SJLee-83/rccar_ota_project/README.md

# SDV 시대의 RC카 - 무선 OTA 업데이트와 AI 음성 제어

SSAFY 임베디드 트랙 15기 1학기 관통 PJT. 차량이 출고 후에도 소프트웨어 업데이트로 기능이 확장되는 **SDV(Software Defined Vehicle)** 개념을 RC카 규모로 구현.

- **무선 OTA 업데이트**: 제어 MCU 에 무선 모듈이 없어도 게이트웨이(ESP32)를 거쳐 펌웨어를 무선 배포하고, 바뀐 펌웨어가 주행 동작 변화로 이어지는 것까지 시연
- **AI 음성 제어**: 사용자 음성을 차량 명령으로 변환하는 인포테인먼트 기능

---

## 개발 계보

구동·제어 베이스를 먼저 구축하고, 그 위에서 OTA 구현이 두 갈래로 분기.

```mermaid
flowchart LR
    BASE["구동·제어 베이스 (이승재)<br/>RA6E1 주행 펌웨어<br/>관제 GUI · MQTT · ESP32 · SPI 명령 체인"]
    A["Dual-Bank OTA · AI 음성 제어 (팀원)<br/>이 저장소 rccar_pjt/ · 최종 시연 채택"]
    B["MCUboot 부트로더 기반 OTA (이승재)<br/>별도 저장소 · 슬롯 교체 검증까지"]

    BASE --> A
    BASE --> B
```

베이스 무선 제어 체인의 원형은 [rccar-mcuboot-ota](https://github.com/SJLee-83/rccar-mcuboot-ota) 의 `gateway/` 이고, 이 저장소 `rccar_pjt/OTA/` 의 `esp32.ino` · `mainwindow.py` 는 원형에 OTA 전송 기능이 얹힌 확장본.

---

## 시스템 아키텍처

```mermaid
flowchart TB
    GUI["PC 관제 GUI<br/>PySide6"]
    PI["Raspberry Pi 5<br/>SPH0645 I2S 마이크<br/>STT · LLM · TTS"]
    BROKER["MQTT Broker<br/>Mosquitto 1883"]
    ESP["ESP32 게이트웨이"]
    RA["Renesas RA6E1 · SPI Slave<br/>Dual-Bank Code Flash 제어<br/>CRC32 검증 · BankSwap · Reset"]
    MOTOR["PCA9685 Motor HAT<br/>서보 조향 + DC 모터 구동"]
    SONIC["HC-SR04 초음파 센서<br/>전방 충돌 감지"]

    GUI -->|MQTT| BROKER
    PI -->|MQTT| BROKER
    BROKER -->|MQTT| ESP
    ESP -->|"SPI Master + BUSY GPIO"| RA
    RA -->|I2C| MOTOR
    SONIC -->|GPIO| RA
```

| 구간 | 프로토콜 | 용도 |
|---|---|---|
| GUI ↔ Broker ↔ ESP32 | MQTT | OTA 데이터, RC 조종 명령, 상태 피드백 |
| ESP32 ↔ RA6E1 | SPI + BUSY GPIO | 펌웨어 청크 전달, 명령, 핸드셰이크 |
| RA6E1 ↔ Motor HAT | I2C | 서보·DC 모터 제어 |
| RA6E1 ↔ HC-SR04 | GPIO | 전방 거리 측정 |
| Pi5 ↔ GMS | HTTPS | STT / LLM / TTS |

---

## 주요 기능

### 1. 무선 OTA (Dual-Bank 방식, 최종 채택)

부트로더 없이 RA6E1 하드웨어의 Dual-Bank + BankSwap 기능으로 구현. 실행 중인 Active Bank 가 새 펌웨어를 받아 반대쪽 Inactive Bank(alias `0x00200000`)에 기록하고, 검증 성공 시 `R_FLASH_HP_BankSwap()` + Reset 으로 교체.

- 256바이트 청크 전송, RA6E1 에서 메타데이터·청크 CRC32 검증 (불일치 시 거부). 전체 이미지 CRC32 는 ESP32 가 전송 완료 시 대조하되 경고만 기록, RA6E1 은 수신만 하고 미대조
- ARQ 재전송 (NACK `0x1F`, 청크당 최대 20회), Session ID, 바이너리 프로토콜
- 다운로드·검증 실패 시 BankSwap 미수행으로 기존 펌웨어 유지

### 2. HC-SR04 충돌 회피 (OTA 가치 시연용)

OTA 로 펌웨어를 바꾸면 기능이 생기는 것을 보이는 시연 구성.

- **V1.0.0 (업데이트 전)**: 장애물 감지 없이 계속 주행
- **V2.0.0 (업데이트 후)**: 전방 20cm 장애물 감지 시 정지, 28cm 이상 3회 연속 확인 후 재출발 (히스테리시스)

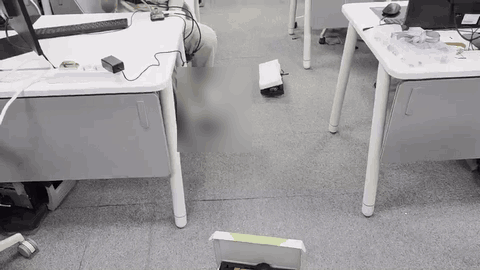
[picture p1: docs/images/demo_collision_avoidance.gif]
충돌 회피 시연


V2.0.0 적용 후 장애물 앞 정지 (발표 시연 영상 발췌)

### 3. AI 음성 제어

라즈베리파이 5 + SPH0645 I2S 마이크로 음성 캡처 후 SSAFY GMS 프록시를 거쳐 STT → LLM → TTS 파이프라인 실행.

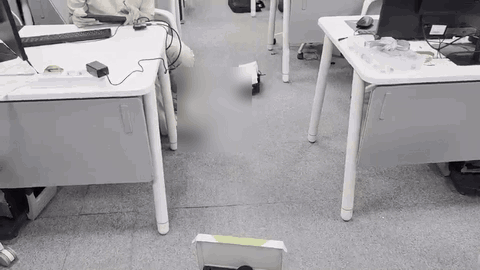
[picture p2: docs/images/demo_voice_control.gif]
음성 제어 시연


음성 명령에 따른 차량 구동 (발표 시연 영상 발췌, 팀원 담당 기능)

---

## 저장소 구성

```
rccar_ota_project/
├── 1st_pjt_rccar_ota/    # RA6E1 애플리케이션 (모터/SPI/I2C 제어)
├── rccar_pjt/            # 팀 통합 작업물
│   ├── OTA/              #   Dual-Bank OTA, ESP32 게이트웨이, 충돌회피
│   ├── ai_audio/         #   AI 음성 비서 (라즈베리파이)
│   └── 최종발표.pptx
├── docs/
│   ├── 01_팀프로젝트_전체정리.md
│   └── images/           #   README gif
└── README.md
```

MCUboot 부트로더 갈래는 [rccar-mcuboot-ota](https://github.com/SJLee-83/rccar-mcuboot-ota) 로 분리. 이 저장소는 팀 결과물만 유지.

---

## 팀원 간 역할 분배

### 팀원 - OTA 시스템 · AI 음성
- Dual-Bank OTA 수신·기록·BankSwap 구현 (최종 시연 채택)
- OTA 전송 프로토콜 설계 (256B 청크, CRC32 검증, ARQ 재전송)
- 기존 관제 GUI 에 OTA 업로드 화면·진행률 대시보드 확장
- GMS 기반 STT·LLM·TTS AI 음성 기능

### 이승재 - RA6E1 펌웨어 · 무선 제어 체인
- PySide6 관제 GUI 및 MQTT 명령 발행 (주행 제어 기반 구현)
- ESP32 게이트웨이: MQTT 수신 → JSON 파싱 → SPI 1바이트 변환
- SPI Slave/BUSY 기반 차량 명령 수신 처리
- MotorHat(PCA9685) I2C 기반 주행·조향 제어
- HC-SR04 초음파 충돌 회피 펌웨어 작성
- 주행·센서 통합 테스트 및 시연 펌웨어 안정화
- MCUboot 부트로더 기반 OTA 방식 독립 시도 (별도 저장소)

---

## OTA 두 방식의 병행 시도

OTA 는 두 접근을 병행 시도한 뒤 하나를 최종 채택. Dual-Bank 는 완성해 시연에 사용했고, MCUboot 는 슬롯 교체 검증까지 도달했으나 무선 전송 미완.

| 항목 | Dual-Bank (팀원, 채택) | MCUboot (이승재) |
|---|---|---|
| 부트로더 | 없음 (앱이 직접 수행) | 있음 (MCUboot) |
| 검증 | CRC32 | ECDSA P-256 서명 |
| 무선 전송 | 완성 | 미완 (self-programming 제약) |
| 최종 시연 | 채택 | 미채택 |

MCUboot 방식 상세와 코드는 [rccar-mcuboot-ota](https://github.com/SJLee-83/rccar-mcuboot-ota) 참조.

프로젝트 상세 정리는 [docs/01_팀프로젝트_전체정리.md](docs/01_팀프로젝트_전체정리.md) 참조.
