SJLee-83/rccar_ota_project/rccar_pjt/OTA/개선점.md

1. OTA 업데이트 도중 RC카가 동작함
-> OTA 업데이트 중에는 RC카가 동작하지 않아야 함
2. 1번 문제의 원인으로는 데이터가 클럭동기로 제대로 전송되지 않는 것 같음.
-> 데이터를 전송할 때 누락되는 데이터 없이 전송되도록 해야 함.
3. 2번 문제를 해결하기 위해서는 펌웨어의 모든 파일이 정상적으로 전송됐는지 확인하는 로직이 필요함.
