SJLee-83/rccar_ota_project/(commit log)

2026-06-25 RC카 MCUboot OTA - C-7a 슬롯 교체 검증, 지그재그 데모 완료
2026-06-25 앱 프로젝트 파일 정상 추가 (중첩 git 제거)
2026-07-03 팀 전체 프로젝트 폴더 추가
2026-07-08 README 및 프로젝트 정리 문서 추가
2026-09-01 MCUboot 갈래 분리 및 README 계보 명시
2026-09-01 MCUboot 갈래 분리, README·정리문서 계보 명시 및 도식 mermaid 전환
2026-09-01 docs/01 문체 기준 전체 적용 및 CRC 검증 서술 정정
2026-09-01 팀원 실명을 역할 표기로 교체
2026-09-01 README 충돌 회피·음성 제어 시연 gif 추가
2026-09-02 docs: motorhat.h에 Adafruit MIT 라이선스 출처 표기 추가
